Ghost-Venom/Fog-Timer/case/fog_case_plate.stl

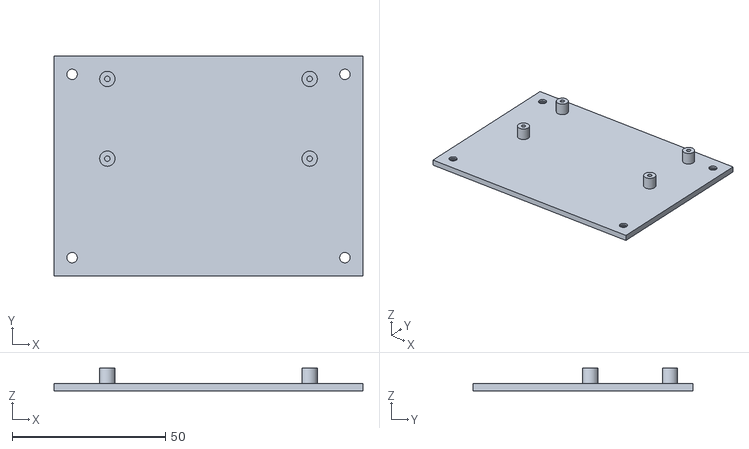
[picture p1: CAD file, 2026-10-28]
case/fog_case_plate.stl
100.8 x 71.6 x 7.40
