Ghost-Venom/Fog-Timer/case/fog_case_preview.stl

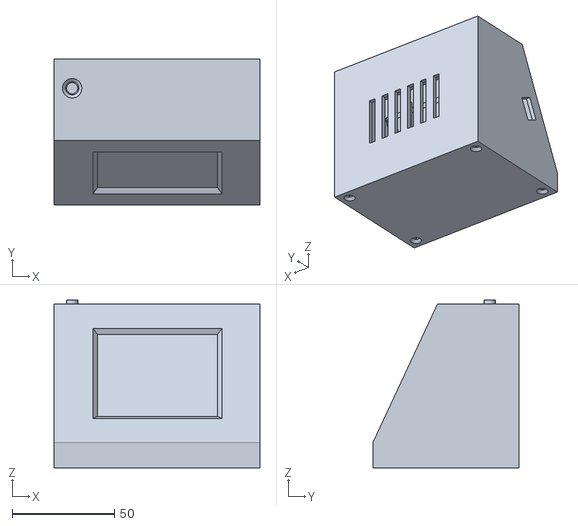
[picture p2: CAD file, 2026-10-28]
case/fog_case_preview.stl
100.8 x 71.6 x 82.2
