Ghost-Venom/Fog-Timer/case/fog_case_shell.stl

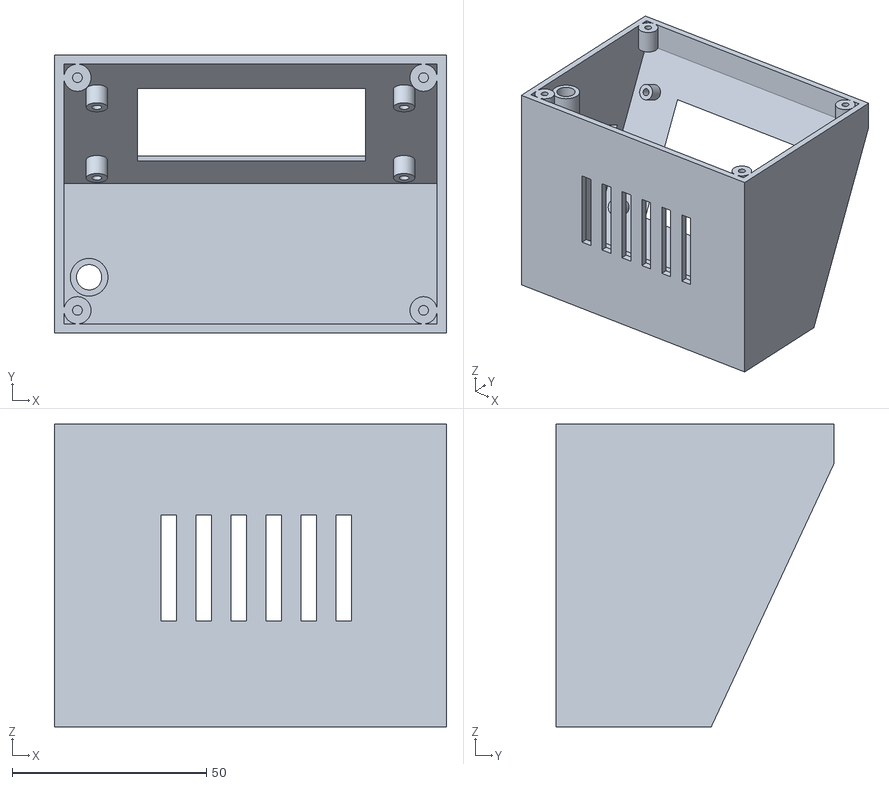
[picture p3: CAD file, 2026-10-28]
case/fog_case_shell.stl
100.8 x 71.6 x 77.8
